JanolovV/Bee-IOT/sketch_receiver_PCB.ino

//Include Libraries
#include <SPI.h>
#include <nRF24L01.h>
#include <RF24.h>

//create an RF24 object
RF24 radio(9, 10);  // CE, CSN

//address through which two modules communicate.
const byte address[6] = "00001";

char text[32] = {0};

void setup()
{
  while (!Serial);
    Serial.begin(9600);
  
  radio.begin();
  radio.setDataRate(2);
  
  //set the address
  radio.openReadingPipe(0, address);
  
  //Set module as receiver
  radio.startListening();
}

void loop()
{
  //Read the data if available in buffer
  if (radio.available())
  {
    radio.read(&text, sizeof(text));
    Serial.println(text);
    }

}
